joshtyler/delay-line/kicad/README.MD

Lattice_iCE_FPGA.lib is from https://github.com/xesscorp/KiCad-Schematic-Symbol-Libraries

kifield -x output_pcb.sch fpga.sch -i output_pcb_fields.csv
Swap fields to go the other way
