joshtyler/delay-line/kicad/output_pcb/README.MD

Lattice_iCE_FPGA.lib is from https://github.com/xesscorp/KiCad-Schematic-Symbol-Libraries

kifield -x output_pcb.sch fpga.sch -i output_pcb_fields.csv
Swap fields to go the other way

Errata:
v1.0 - BAT54s diode is backwards, remedy is solder upside down.
