joshtyler/delay-line/report/docs/appendices.tex

\clearpage
\begin{appendices}
	
\chapter{Folder Structure} \label{sec:folder-struct}

The project is structured as a single repository using the git version control system. For the reader unfamiliar with git, the project folder may be treated as an ordinary computer folder, however there exists inside the root of the directory a hidden folder, \texttt{.git}, which contains the entire history of the project. This history is not of use to a user only interested in the latest state of the project, but is useful to find files or parts of files which may have been deleted. An example of such files are the project files for the Lattice and Xilinx toolchains, which were later replaced in the project by the open-source Project IceStorm toolchain.

The philosophy of the project repository is that it should not contain any:
\begin{itemize}
	\item Files not directly related to the project itself (e.g. reference material)
	\item Auxillary files automatically generated by tools
	\item Binary files that may be easily regenerated by tools
\end{itemize}
but should contain:
\begin{itemize}
	\item Design files
	\item Project files/configuration files used by tools
	\item Documentation files, even if they may be re-generated (e.g. \LaTeX{} generated \texttt{.pdf} files), provided they are not excessively bulky.
\end{itemize}
This philosophy is enforced inside the repository using \texttt{.gitignore} files.

The structure of each sub-folder in the project repository is shown Figure \ref{fig:repo-dir-struct} (in alphabetical order).

Note that unlabelled folders contain identical types of files to the same name of folder elsewhere in the hierarchy.

\begin{figure}[ht]
	\dirtree{%
		.1 admin \DTcomment{Administration files. E.g. purchase orders}.
		.1 demo \DTcomment{\LaTeX{} files used to generate the project demonstration slides}.
			.2 figs \DTcomment{Figures used in the slides}.
		.1 hdl \DTcomment{\Glsentryshort{hdl} design files/project files, and simulation testbenches}.
			.2 common \DTcomment{Common Verilog constructs used across multiple designs}.
				.3 sim \DTcomment{SystemVerilog Simulation testbenches}.
				.3 sim\_modelsim \DTcomment{ModelSim project file for simulation}.
				.3 src \DTcomment{Synthesizable Verilog code}.
			.2 delay\_line \DTcomment{Files related to the delay line \glsentryshort{hdl} design}.
				.3 icestorm \DTcomment{Makefile for the Project IceStorm toolchain}.
				.3 sim.
				.3 sim\_modelsim.
				.3 src.
			.2 test\_harness \DTcomment{Files related to the test harness \glsentryshort{hdl} design}.
				.3 icestorm.
				.3 sim.
				.3 sim\_modelsim.
				.3 src.
		.1 report \DTcomment{\LaTeX files used to generate the project report (this document)}.
			.2 docs \DTcomment{\LaTeX source files that are not the master project file}.
			.2 figs.
			.2 refs \DTcomment{Files for \textsc{Bib}\TeX{} referencing}.
		.1 sch \DTcomment{Contains KiCAD files used to draw the schematics for the project}.
			.2 delay\_line \DTcomment{Contains the schematic files of the delay line}.
			.2 delay\_line \DTcomment{Contains the schematic files of the test harness}.
		.1 software \DTcomment{Supporting software intended to run on a \glsentryshort{pc}}.
			.2 mem\_gui \DTcomment{Source related to the \glsentryshort{gui} software that talks to the test harness}.
				.3 {.idea} \DTcomment{Project files for CLion}.
				.3 ftdi\_wrapper \DTcomment{Source for wrapping the FTDI driver}.
				.3 generic\_classes \DTcomment{Source for classes used in various parts of the project}.
				.3 main\_gui \DTcomment{Source to implement \glsentryshort{gui} itself}.
				.3 memory\_manager \DTcomment{Source to monitor each unit of \glsentryshort{edsac} memory}.
				.3 status\_manager \DTcomment{Source to control the state of the system}.
				.3 uart\_manager \DTcomment{Source to control the transmission and receipt of messages}.
				.3 uart\_msg \DTcomment{Source relating to \glsentryshort{uart} message formats}.
			.2 uart\_msg\_const\_gen \DTcomment{A script to generate \glsentryshort{uart} message constant header files}.
				.3 cpp\_out \DTcomment{Output folder for C++ header(s)}.
				.3 verilog\_out \DTcomment{Output folder for Verilog header(s)}.
		.1 spice \DTcomment{LTspice simulation schematics}.
			.2 component\_models \DTcomment{Models for various components used in the design}.
	}
	\caption{Repository directory structure}
	\label{fig:repo-dir-struct}
\end{figure}

\chapter{Project Planning Charts} \label{app:proj-plan-charts}

This Gantt Chart shown in Figure \ref{fig:gantt-chart} shows how time on the project was actually spent, and this is in comparison to the \gls{pert} chart of Figure \ref{fig:pert-chart} which shows how time was initially planned to be spent at the start of the project.

These charts are discussed more fully in Chapter \ref{sec:project-planning}.

%Redefine drawing constants to what they were in the lit review.
%Hacky but it works
%Just be sure to not use any of the "normal" tikz setup after this point
\renewcommand{\tikzStateNodeDist}{0.75cm}
\newcommand{\tikzBoxWidth}{3.25cm}

\tikzset{font={\footnotesize}} %set small font
\tikzstyle{every state}=[rectangle, rounded corners, fill=black!40,draw=none,minimum width=\tikzBoxWidth,minimum height=2cm] %Setup state machine style
\tikzstyle{pert}=[->, ,>=stealth', auto,node distance=\tikzStateNodeDist,thick, initial text=Reset]

\tikzstyle{critical} = [fill=red!40]
\tikzstyle{criticalPath} = [draw=red]

\newcommand{\pertNode}[4]
{
	\node[state] (#1) [#2]
	{
		\begin{tabular}{c}
			\textbf{\shortstack{#3}}\\
			\hline
			\shortstack{#4}
		\end{tabular}	
	};	
}

\begin{landscape}
\begin{figure}
	\centering
	\begin{tikzpicture}[pert]
	
	\pertNode{lit}{critical}{Literature\\Review}{2 Weeks}
	
	\pertNode{tb-des}{right=of lit}{Test Harness\\Design}{1 Week}
	\pertNode{delay-des}{critical,above =of tb-des}{Delay Line\\Design}{2 Weeks}
	\pertNode{amp-des}{below =of tb-des}{Amplifier\\Design}{1 Week}
	
	\pertNode{tb-const}{right=of tb-des}{Test Harness\\Implementation\\and Testing}{1 Week}
	\pertNode{delay-const}{critical, right=of delay-des}{Delay Line\\Implementation\\and Testing}{2 Weeks}
	\pertNode{amp-const}{right=of amp-des}{Amplifier\\Implementation\\and Testing}{2 Weeks}
	
	\coordinate (meet) at ([xshift=\tikzStateNodeDist] tb-const.east);
	
	\pertNode{pcb-des}{critical, right= 2*\tikzStateNodeDist of tb-const}{PCB\\Design}{1 Week}
	
	\pertNode{pcb-test}{critical, right=of pcb-des}{PCB\\Construction\\and Testing}{1 Week}
	
	\pertNode{pcb-doc}{critical, right=of pcb-test}{Formal PCB\\Documentation}{1 Week}
	
	\pertNode{des-doc}{below=of pcb-test}{Formal Design\\Documentation}{2 Weeks}
	
	\coordinate (finish) at ([xshift=\tikzStateNodeDist] pcb-doc.east);
	
	\node[above] at (finish) {Finish};

	\path	(lit)			edge							(tb-des)
	(tb-des)		edge							(tb-const)
	(tb-const)		edge							(meet)
	%
	(lit)			edge[bend left, criticalPath]	(delay-des)
	(delay-des)		edge[criticalPath]				(delay-const)
	(delay-const)	edge[bend left, criticalPath]	(meet)
	%
	(lit)			edge[bend right]				(amp-des)
	(amp-des)		edge							(amp-const)
	(amp-const)		edge[bend right]				(meet)
	%
	(meet)			edge[criticalPath]				(pcb-des)
	(pcb-des)		edge[criticalPath]				(pcb-test)
	%
	(meet)			edge[bend right]				(des-doc)
	(des-doc)		edge[bend right]				(finish)
	%
	(pcb-test)		edge[criticalPath]				(pcb-doc)
	(pcb-doc)		edge[criticalPath]				(finish);
	
	\end{tikzpicture}
	\caption{\glsentryshort{pert} chart used to plan the project}
	\label{fig:pert-chart}
\end{figure}
\end{landscape}

\begin{figure}
	\centering
	\resizebox{\textwidth}{!}{
		\input{figs/gantt/gantt}	
	}
	\caption{Gantt chart showing how time was allocated in the project}
	\label{fig:gantt-chart}
\end{figure}

\chapter{Schematics}
This appendix includes the schematics for the delay line and test harness.

%\begin{landscape}
	\includepdf[landscape]{figs/schematics/delay_line}
	\includepdf[landscape]{figs/schematics/test_harness}
%\end{landscape}

\chapter{\glsentryshort{hdl} verification results} \label{app:sim-wfms}
This appendix includes the the simulation waveforms resulting from verification.

The waveforms are included here since they are more clearly presented in landscape format, however they are discussed in Section \ref{sec:hdl-verif}.

\begin{landscape}

\begin{figure}[ht]
	\centering
	
	\begin{subfigure}[b]{\linewidth}
		\centering
		
		\caption{Full simulation}
		\label{fig:delay-sim-full}
	\end{subfigure}
	
	\begin{subfigure}[b]{\linewidth}
		\centering
		
		\caption{Simulated output of a single pulse}
		\label{fig:delay-sim-single}
	\end{subfigure}
	
	\caption{Delay line simulation results}
	\label{fig:delay-sim}
\end{figure}

\begin{figure}[ht]
	\centering
	
	\caption{Full Simulation}
	\label{fig:harness-full}
\end{figure}

\end{landscape}

\end{appendices}
