joshtyler/delay-line/report/docs/acronyms.tex

\newacronym{edsac}{EDSAC}{electronic delay storage automatic calculator}
\newacronym{eniac}{ENIAC}{electronic numerical integrator and computer}
\newacronym{tnmoc}{TNMoC}{The National Museum of Computing}
\newacronym{leo}{LEO}{Lyons electronic office}
\newacronym{fpga}{FPGA}{field programmable gate array}
\newacronym{dc}{DC}{direct current}
\newacronym{ac}{AC}{alternating current}
\newacronym{pcb}{PCB}{printed circuit board}
\newacronym{ram}{RAM}{random access memory}
\newacronym{hdl}{HDL}{hardware description language}
\newacronym{fifo}{FIFO}{first in, first out}
\newacronym{risc}{RISC}{reduced instruction set computing}
\newacronym{arm}{ARM}{advanced RISC machine} %This breaks if using \gls{risc}
\newacronym{uart}{UART}{universal asynchronous receiver/transmitter}
\newacronym{gpio}{GPIO}{general purpose input/output}
\newacronym{ic}{IC}{integrated circuit}
\newacronym{rc}{RC}{resistor-capacitor}
\newacronym{cpld}{CPLD}{complex programmable logic device}
\newacronym{pll}{PLL}{phase locked loop}
\newacronym{lc}{LC}{logic cell}
\newacronym{lut}{LUT}{look-up table}
\newacronym{tqfp}{TQFP}{thin quad flat package}
\newacronym{vhdl}{VHDL}{VHSIC hardware definition language}
\newacronym{spice}{SPICE}{simulation program with integrated circuit emphasis}
\newacronym{lvcmos}{LVCMOS}{low voltage complementary metal oxide semiconductor}
\newacronym{gbp}{GBP}{gain-bandwidth product}
\newacronym{ldo}{LDO}{low-dropout}
\newacronym{rcbo}{RCBO}{residual-current circuit breaker with overcurrent protection}
\newacronym{rms}{RMS}{root mean square}
\newacronym{pc}{PC}{personal computer}
\newacronym{gui}{GUI}{graphical user interface}
\newacronym{pld}{PLD}{programmable logic device}
\newacronym{pert}{PERT}{project evaluation and review technique}
\newacronym{usb}{USB}{universal serial bus}
\newacronym{ftdi}{FTDI}{Future Technology Devices International}
\newacronym{spi}{SPI}{serial peripheral interface}
\newacronym{hf}{HF}{high frequency}
\newacronym{hv}{HV}{high voltage}
