joshtyler/delay-line/report/figs/gantt/gantt.tex

%\documentclass{standalone}
%\usepackage{pgfgantt} %Gantt charts
%\begin{document}
\begin{ganttchart}[hgrid, vgrid, x unit=2mm, title label font = \footnotesize, time slot format =isodate]{2017-06-05}{2017-09-09}
	\gantttitlecalendar{year, month=name, week=1}\\
		
	\ganttgroup[name=delay-hdl]{Initial delay line HDL implementation}{2017-06-06}{2017-06-13} \\
	\ganttbar[name=delay-research]{Architecture Research}{2017-06-06}{2017-06-06} \\
	\ganttlinkedbar{Verilog Implementation}{2017-06-07}{2017-06-13} \\
	\ganttbar[name=delay-tb]{Testbench Design}{2017-06-07}{2017-06-13}\\
	\ganttlink{delay-research}{delay-tb}
	
	\ganttgroup[name=harness-hdl]{Initial test harness HDL implementation}{2017-06-13}{2017-06-21} \\
	\ganttbar[name=harness-sys-des]{Requirements capture and system design}{2017-06-13}{2017-06-13} \\
	\ganttlinkedbar{Verilog Implementation}{2017-06-13}{2017-06-21} \\
	\ganttbar[name=harness-tb]{Testbench Design}{2017-06-13}{2017-06-21} \\
	\ganttlink{harness-sys-des}{harness-tb}
	
	\ganttgroup[name=gui]{Initial Test Harness GUI Design}{2017-06-21}{2017-06-29} \\
	\ganttbar{Creation of proof-of-concept UART driver program}{2017-06-21}{2017-06-22} \\
	\ganttbar{C++ program architecture design}{2017-06-22}{2017-06-22} \\
	\ganttlinkedbar{C++ implementation}{2017-06-23}{2017-06-29} \\

	\ganttgroup[name=initial-integ]{Digital design integration and improvement}{2017-07-03}{2017-07-11} \\
	\ganttlink{delay-hdl}{initial-integ}
	\ganttlink{harness-hdl}{initial-integ}
	\ganttlink{gui}{initial-integ}
	
	\ganttbar{Integration testing of test harness GUI, test harness, and delay line}{2017-07-03}{2017-07-07} \\
	\ganttlinkedbar{GUI improvements}{2017-07-07}{2017-07-11} \\
	
	\ganttgroup[name=init-ana]{Initial Analogue Design}{2017-07-12}{2017-07-17} \\
	\ganttbar[name=pwr-investig]{FPGA power investigation}{2017-07-12}{2017-07-12} \\
	\ganttbar{Test harness input/output amplifier design}{2017-07-13}{2017-07-17} \\
	\ganttbar[name=phantom-power-design]{Phantom power circuitry design}{2017-07-17}{2017-07-17} \\
	\ganttlink{pwr-investig}{phantom-power-design}
	
	\ganttgroup[name=phantom-pwr]{Phantom power investigation}{2017-07-19}{2017-08-02} \\
	\ganttlink{init-ana}{phantom-pwr}
	\ganttbar{Research into how valve design works}{2017-07-19}{2017-07-20} \\
	\ganttlinkedbar{SPICE simulation of EDSAC output stage, and phantom power draw}{2017-07-24}{2017-07-27} \\
	\ganttlinkedbar{Redesign of phantom power circuitry}{2017-07-28}{2017-07-31} \\
	\ganttlinkedbar{Investigation into regeneration input circuitry}{2017-08-01}{2017-08-02} \\
	
	\ganttgroup[name=final-build]{Building final delay line circuitry}{2017-08-03}{2017-09-01} \\
	\ganttlink{init-ana}{final-build}
	\ganttlink{phantom-pwr}{final-build}
	\ganttbar{Selection of parts to order, and ordering}{2017-08-03}{2017-08-04} \\
	\ganttlinkedmilestone{Parts ordered}{2017-08-04} \\
	\ganttlinkedmilestone{Parts arrive}{2017-08-09} \\
	\ganttlinkedbar{Assembling and testing sub-systems}{2017-08-10}{2017-08-15} \\
	\ganttlinkedbar[name=integ-for-demo]{Integration testing and modification}{2017-08-16}{2017-08-22} \\
	\ganttlinkedbar{Re-implement part of circuit to improve noise crosstalk}{2017-08-25}{2017-08-28} \\
	\ganttlinkedbar[name=tmnoc-prep]{Preparation of project to visit TNMoC}{2017-09-01}{2017-09-01} \\

	\ganttmilestone{Visit to TNMoC}{2017-06-27}
	\ganttmilestone[name=tmnoc-second-visit]{Visit to TNMoC}{2017-09-04} \\
	\ganttlink{tmnoc-prep}{tmnoc-second-visit}
	
	\ganttmilestone[name=demo]{Project demonstration}{2017-08-30} \\
	\ganttlink{integ-for-demo}{demo}
	
	\ganttmilestone[name=handin]{Report handin}{2017-09-07} \\
	
	\ganttgroup{Documentation}{2017-08-07}{2017-09-06} \\
	\ganttbar{Report writing}{2017-08-07}{2017-08-09}
	\ganttbar{}{2017-08-23}{2017-08-24}
	\ganttbar{}{2017-08-30}{2017-08-31}
	\ganttbar{}{2017-09-02}{2017-09-03}
	\ganttbar{}{2017-09-05}{2017-09-05} \\
	\ganttbar{Design of diagrams}{2017-08-29}{2017-08-29} \\
	\ganttbar[name=checking]{Report checking}{2017-09-06}{2017-09-06} \\
	\ganttlink{checking}{handin}	
	
\end{ganttchart}
%\end{document}
