joshtyler/delay-line/report/figs/driver-heatsink.jpg

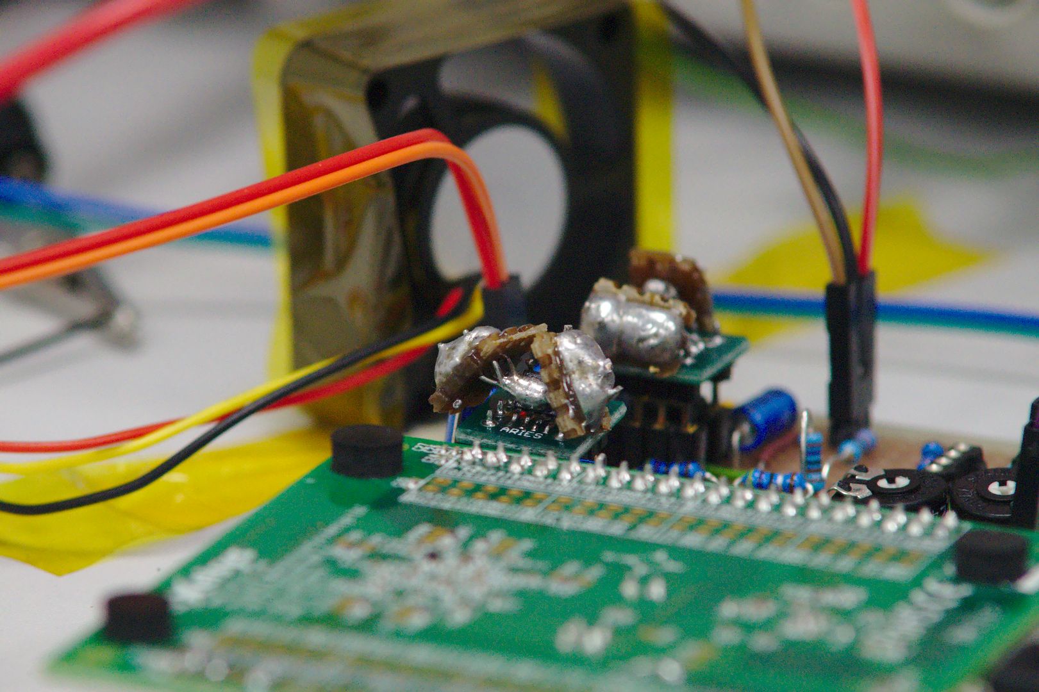
report/figs/driver-heatsink.jpg
