joshtyler/delay-line/report/figs/integration/fpga_reset.jpg

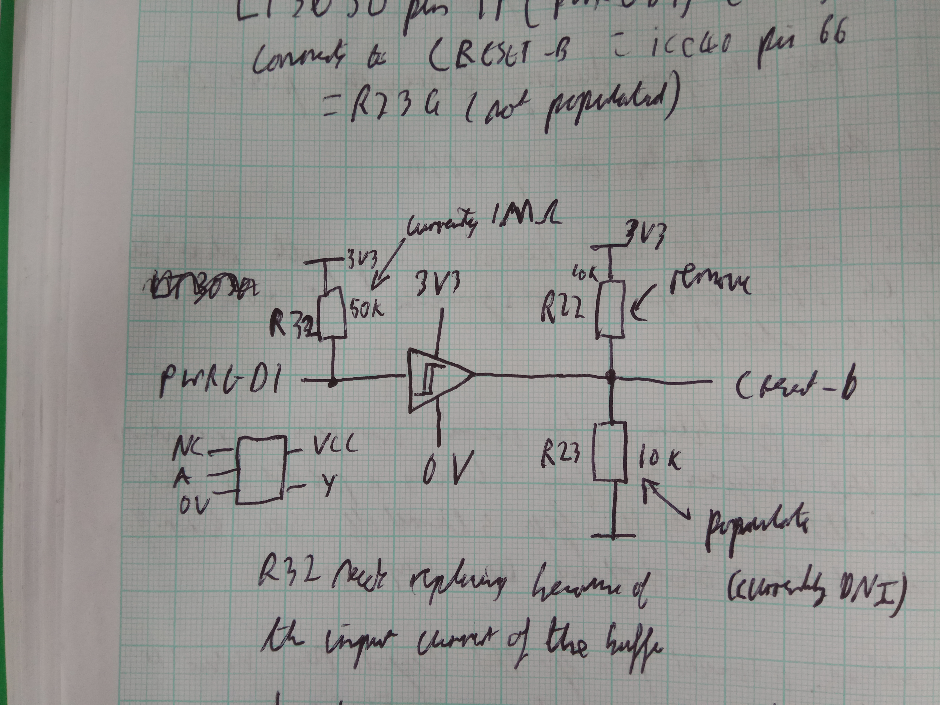
report/figs/integration/fpga_reset.jpg
