joshtyler/delay-line/report/figs/integration/passive_attenuator.jpg

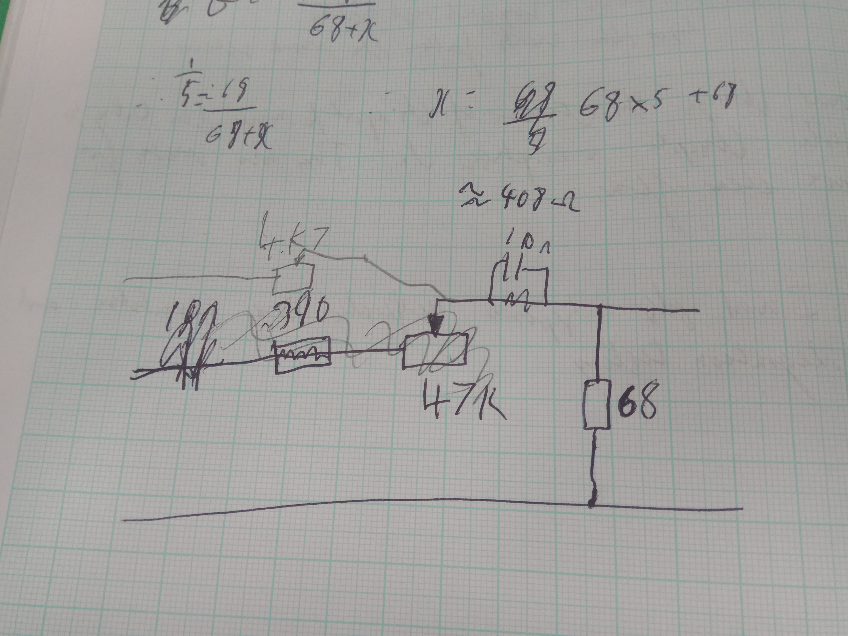
report/figs/integration/passive_attenuator.jpg
