joshtyler/delay-line/report/figs/schematic_portions/delay_line_input.png

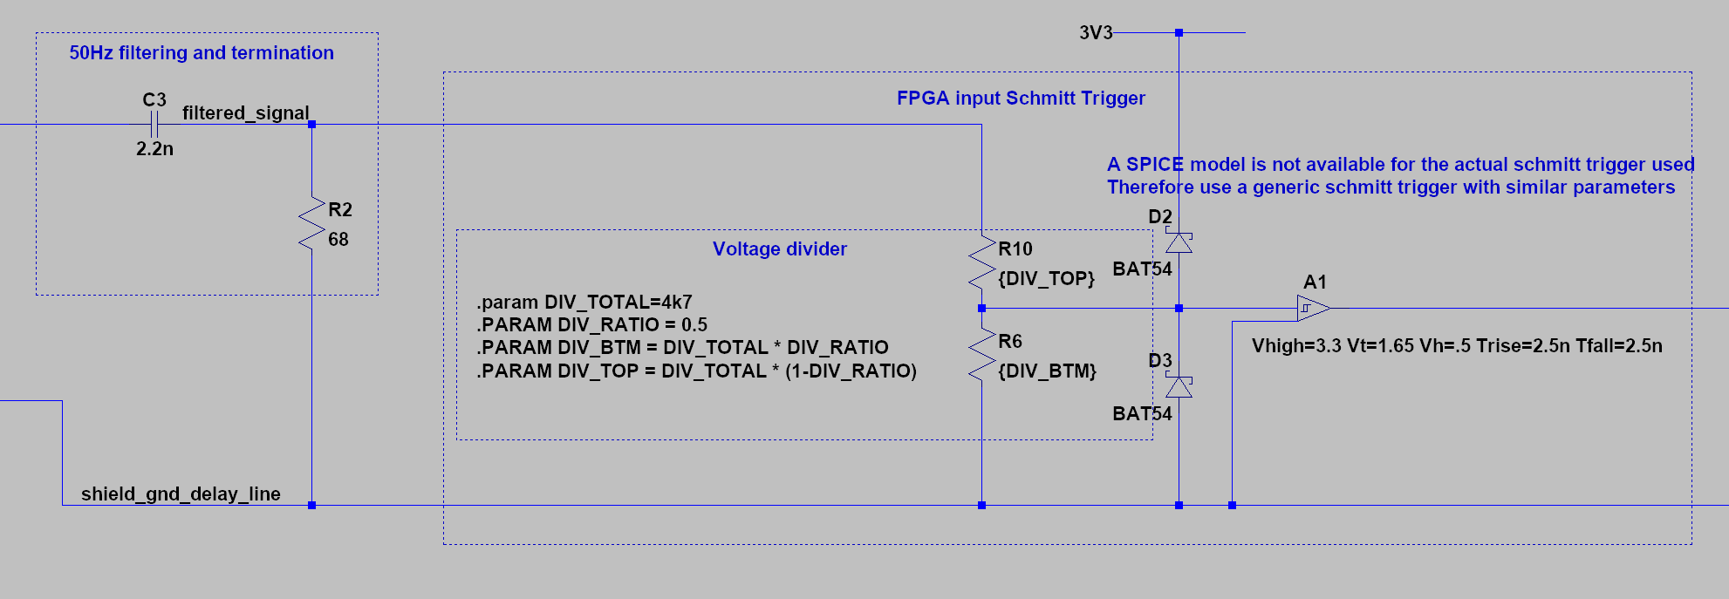
report/figs/schematic_portions/delay_line_input.png
