joshtyler/delay-line/report/figs/schematic_portions/delay_line_output.jpg

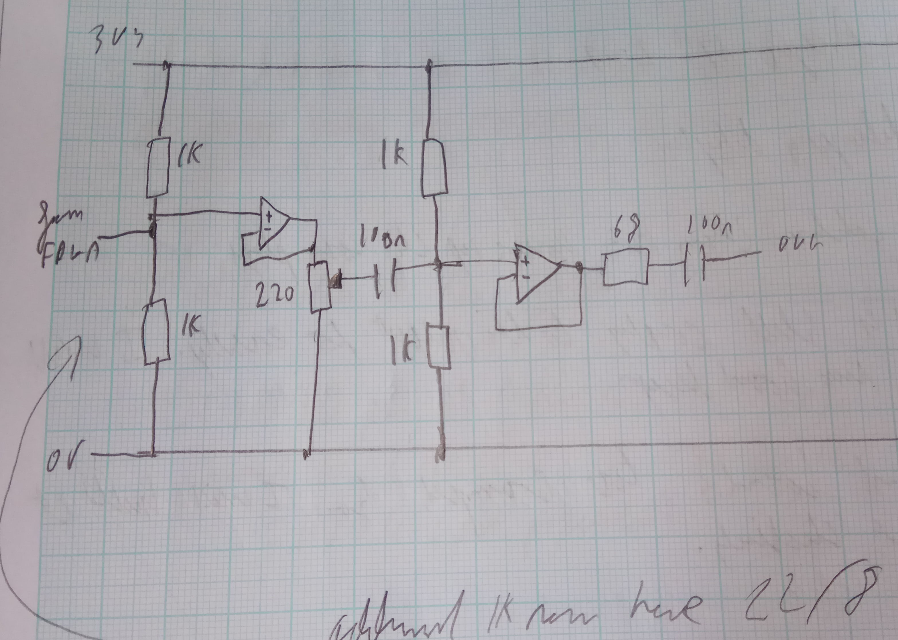
report/figs/schematic_portions/delay_line_output.jpg
