joshtyler/delay-line/report/figs/schematic_portions/delay_line_psu.jpg

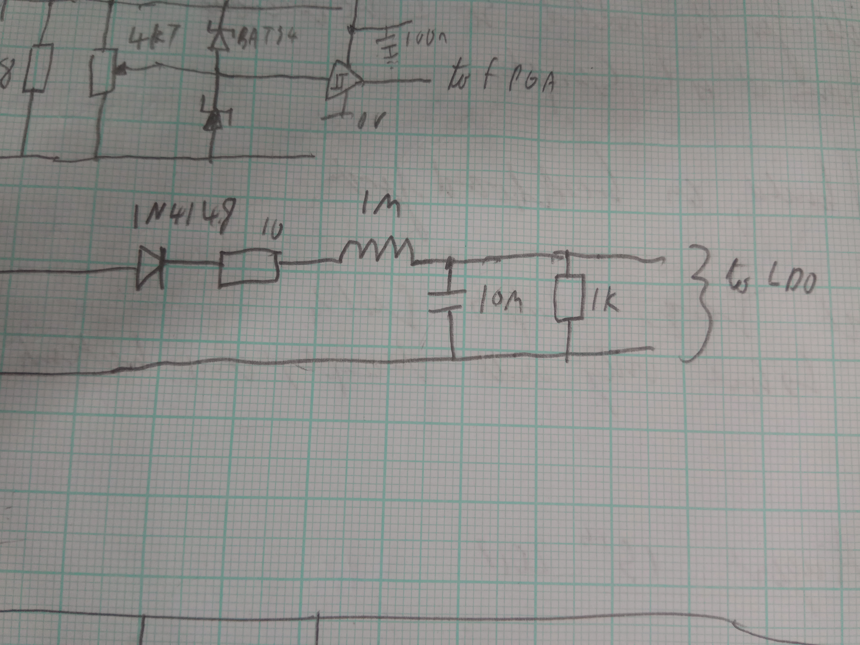
report/figs/schematic_portions/delay_line_psu.jpg
