joshtyler/delay-line/admin/Farnell order 20170804.ods

Part | MOQ | Qty to order | Supplier | Order Code | Price Each | Price Total
BAT54S Shottkey diodes | 1 | 25 | Farnell | 1612328 | £0.07 | £1.73
68Ohm 3W resistor | 1 | 5 | Farnell | 1738673 | £0.18 | £0.89
74LVC1G17W5-7 Schmitt trigger | 1 | 10 | Farnell | 1893835 | £0.26 | £2.60
1mH Inductor | 1 | 5 | Farnell | 2457854 | £0.48 | £2.41
10mF Cap | 1 | 3 | Farnell | 2346513 | £1.88 | £5.64
LMH6639 op-amp | 1 | 5 | Farnell | 1312810 | £1.25 | £6.25
LM7372 op-amp | 1 | 3 | Farnell | 1286929 | £5.44 | £16.32
SOT-23 adapter | 1 | 7 | Farnell | 2474683 | £1.62 | £11.34
SOIC adapter | 1 | 3 | Farnell | 2476033 | £2.05 | £6.15
Matrixboard | 1 | 1 | Farnell | 2762514 | £2.58 | £2.58
Matrixboard | 1 | 1 | Farnell | 2474675 | £3.43 | £3.43
Total |  |  |  |  |  | £59.34
