joshtyler/delay-line/spice/component_models/README.MD

This folder contains the simulation models for various components
