joshtyler/delay-line/admin/Farnell order 20180206.ods

Part | Min qty needed | Qty to order | Supplier | Order Code | Price Each | Price Total | Comment | Quick order
68R 0603 R | 2 | 50 | RS | 213-2115 | £0.00 | £0.15 |  | 213-2115,50
100k 0603 R | 1 | 5 | RS | 566-787 | £0.09 | £0.46 |  | 566-787,5
100u 1210 C | 1 | 5 | RS | 846-7363 | £0.78 | £3.89 |  | 846-7363,5
10u 0805 C | 2 | 10 | RS | 698-3544 | £0.08 | £0.81 |  | 698-3544,10
1k 0603 R | 2 | 50 | RS | 213-2266 | £0.01 | £0.40 |  | 213-2266,50
220k 0603 R | 1 | 50 | RS | 213-2581 | £0.01 | £0.70 |  | 213-2581,50
22u 0603 C | 1 | 10 | RS | 758-8083 | £0.13 | £1.33 |  | 758-8083,10
SMA Right angle | 5 | 5 | RS | 783-9647 | £1.23 | £6.15 |  | 783-9647 ,5
iCE40-HX1K-TQ144 | 1 | 2 | RS | 772-0041 | £4.62 | £9.24 | Could order 1 | 772-0041,2
LFSPXO025492 | 1 | 2 | RS | 671-5701 | £2.81 | £5.62 |  | 671-5701 ,2
MBR0520L Diode | 2 | 10 | RS | 739-0521 | £0.27 | £2.66 |  | 739-0521,10
SST25VF512A EEPROM | 1 | 5 | RS | 723-8757 | £0.36 | £1.80 |  | 723-8757,5
2n2 0603 C | 1 | 25 | RS | 264-4573 | £0.02 | £0.50 |  | 264-4573,25
Total |  |  |  |  |  | £33.71
Order from ebay
LM1117-3.3 | x
0603 Red LEDs | x
NCV8114ASN120T1G | X
