joshtyler/delay-line/report/figs/integration/testing.jpg

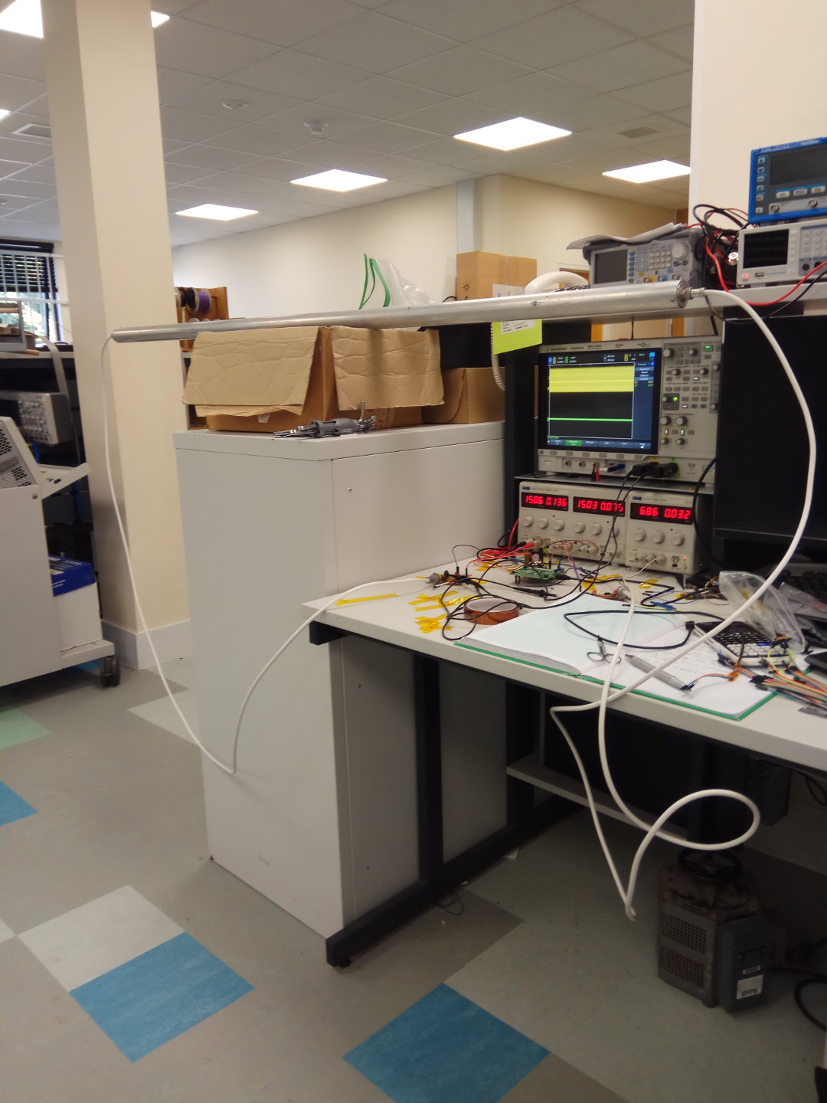
report/figs/integration/testing.jpg
