joshtyler/delay-line/report/figs/schematic_portions/test_harness_input.jpg

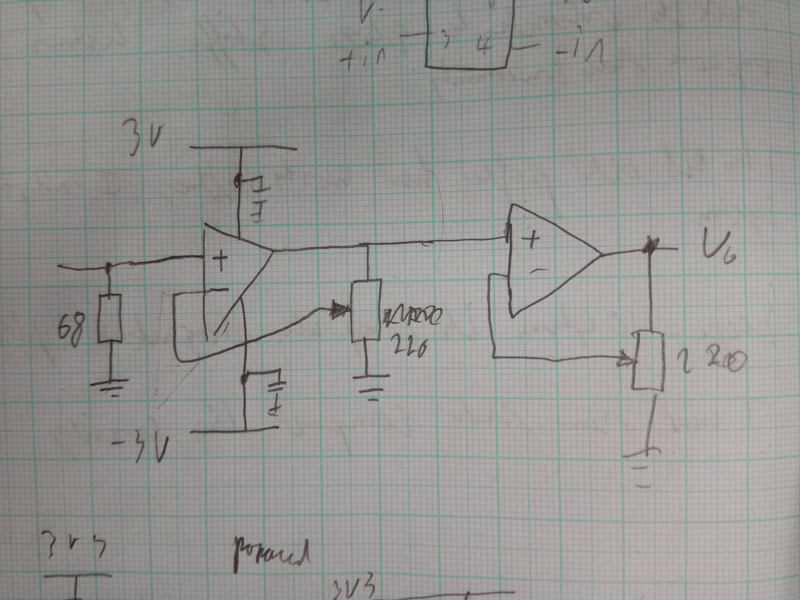
report/figs/schematic_portions/test_harness_input.jpg
