joshtyler/delay-line/report/figs/schematic_portions/test_harness_output.jpg

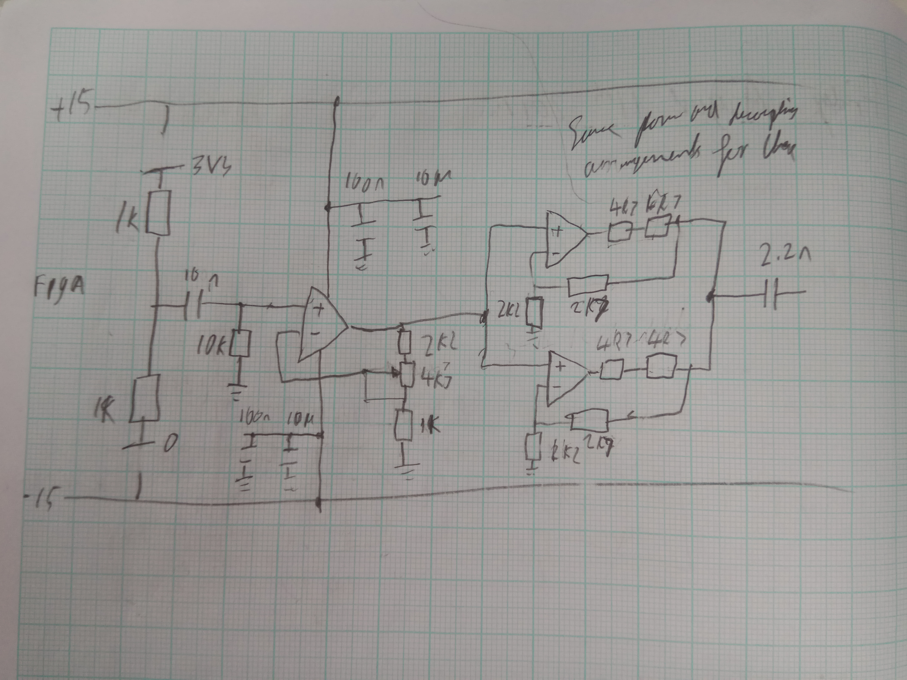
report/figs/schematic_portions/test_harness_output.jpg
