joshtyler/delay-line/report/figs/gantt/gantt.pdf

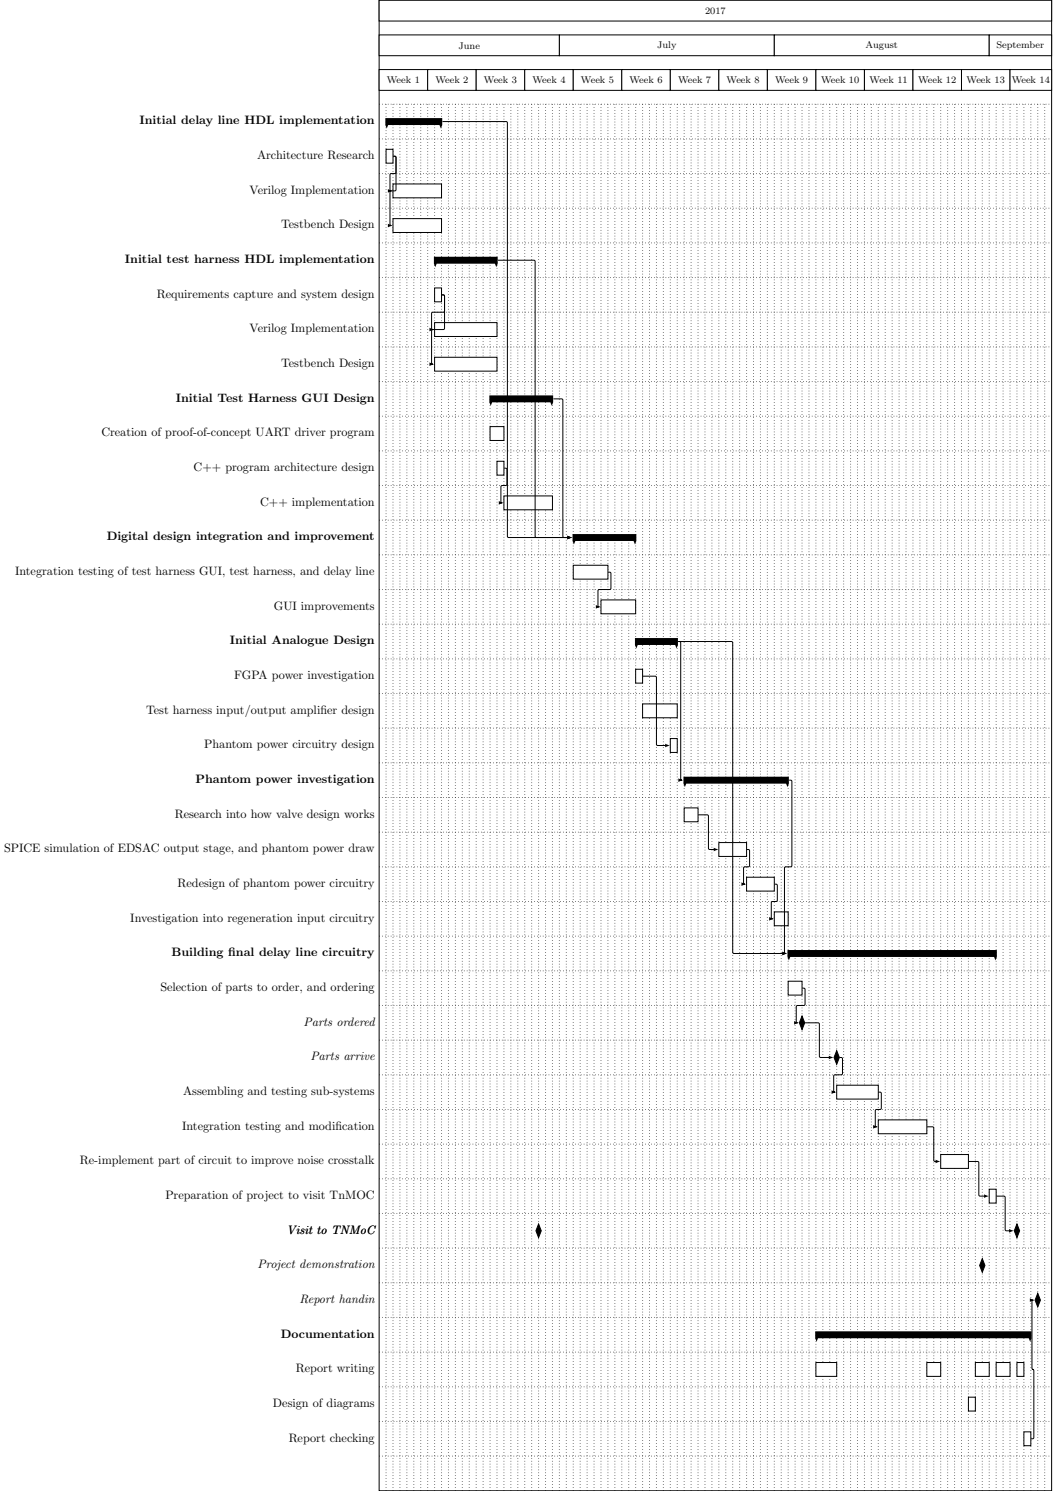
[picture p53: page 1]
June; July; August; September; Week 1; Week 2; Week 3; Week 4; Week 5; Week 6; Week 7; Week 8; Week 9; Week 10 Week 11 Week 12 Week 13 Week 14; Architecture Research; Verilog Implementation; Testbench Design; C++ implementation; GUI improvements; Parts ordered; Parts arrive; Project demonstration; Report handin; Documentation; Report writing; Report checking

Initial delay line HDL implementation

Initial test harness HDL implementation

Requirements capture and system design

Initial Test Harness GUI Design

Creation of proof-of-concept UART driver program

C++ program architecture design

Digital design integration and improvement

Integration testing of test harness GUI, test harness, and delay line

Initial Analogue Design

FGPA power investigation

Test harness input/output amplifier design

Phantom power circuitry design

Phantom power investigation

Research into how valve design works

SPICE simulation of EDSAC output stage, and phantom power draw

Redesign of phantom power circuitry

Investigation into regeneration input circuitry

Building final delay line circuitry

Selection of parts to order, and ordering

Assembling and testing sub-systems

Integration testing and modification

Re-implement part of circuit to improve noise crosstalk

Preparation of project to visit TnMOC

Visit to TNMoC

Design of diagrams
