joshtyler/delay-line/report/figs/equivalent_circuit/equivalent_circuit.pdf

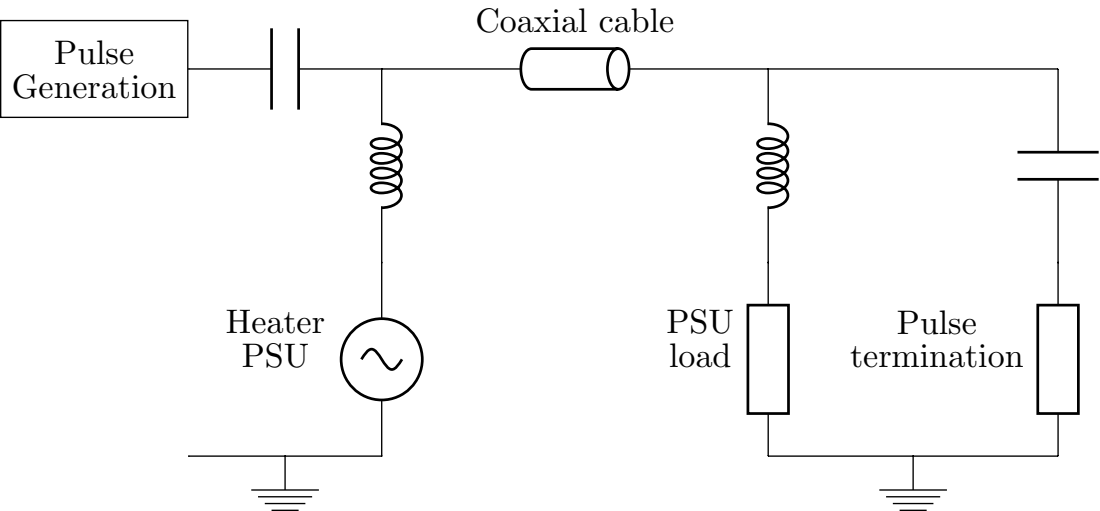
[picture p54: page 1]
Pulse Generation; Heater PSU; Coaxial cable; PSU load; Pulse termination
