joshtyler/delay-line/sch/test_harness.pdf

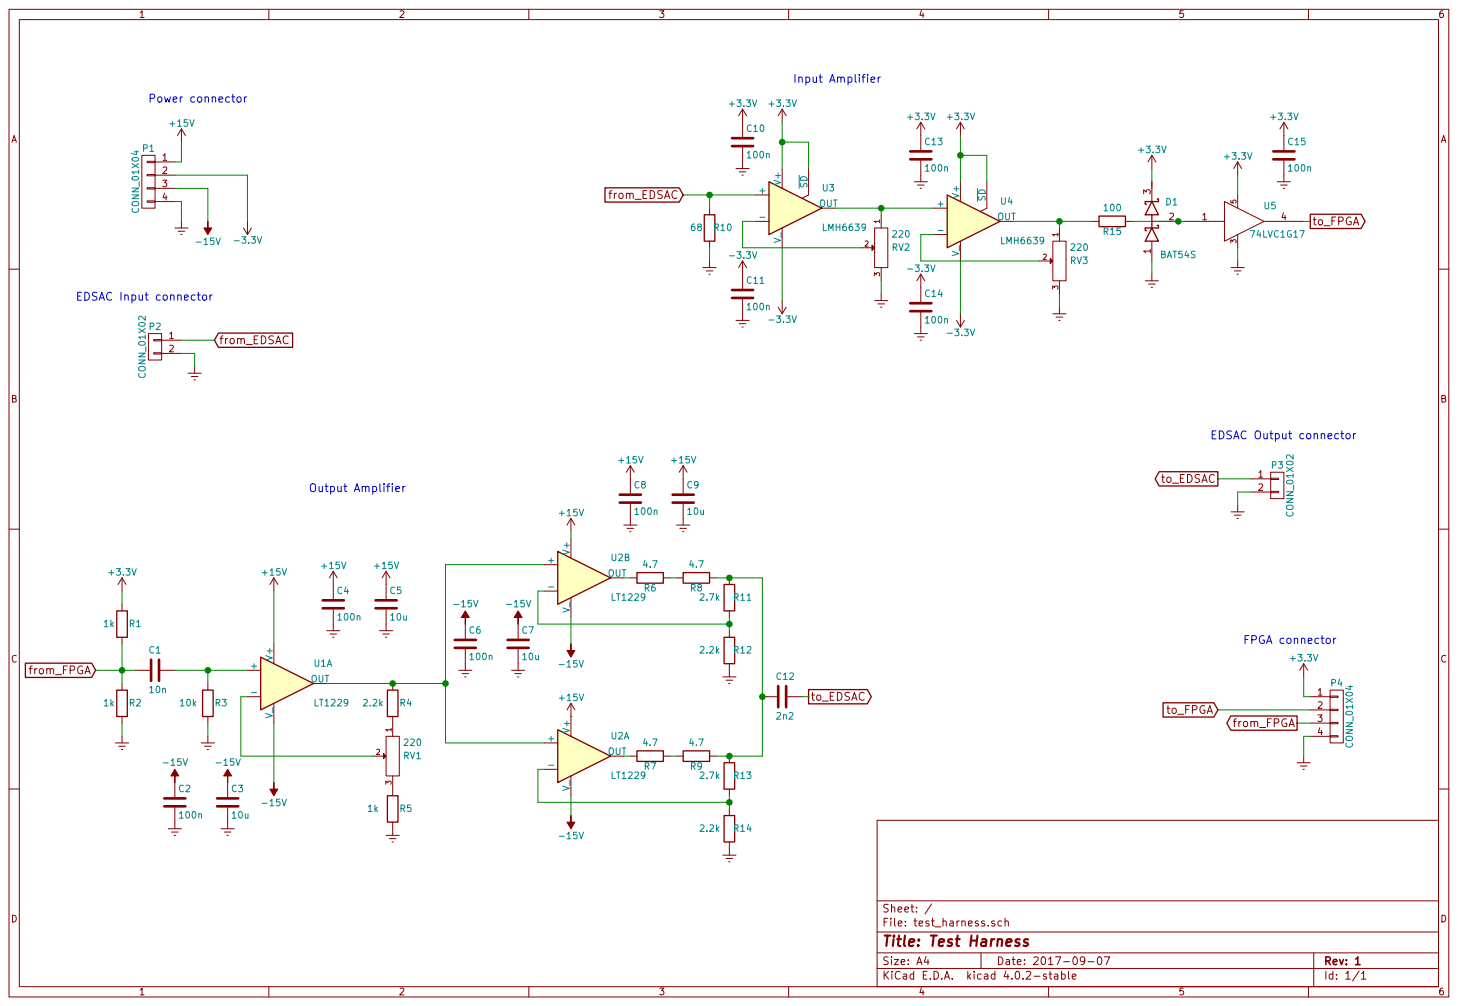
[picture p55: page 1]

File: test_harness.sch Sheet: /
Id: 1/1 Title: Test Harness
