joshtyler/delay-line/spice/test_harness_input.asc

A1: schmtbuf; Vhigh=3.3 Vt=1.65 Vh=.5 Trise=2.5n Tfall=2.5n
B1: bv; V=V(mod)*V(carrier)
C3: cap; 4.7µ
D1: schottky; BAT54
D2: schottky; BAT54
R1: res; 1k
R2: res; 2.2k
R3: res; 220
R5: res; 2.2k
R6: res; 22
R8: res; 68
U1: LT1229
U2: LT1229
V1: voltage; 15
V2: voltage; 15
V3: voltage; 3.3
V4: voltage; PULSE(-50m 50m 0 1n 1n 37n 74n)
V5: voltage; PULSE(0 1 0 0 0 0.9u 1.9u)
Named nets: 0, mod, carrier, in, amp1_out, fpga_in, amp2_out, 3V3
.tran 0 110u 100u
