joshtyler/delay-line/spice/test_harness_output.asc

B1: bv; V=1.65+V(carrier)*V(pulse)
C1: cap; 10n
C2: cap; 2.2n
C3: cap; 100n
C4: cap; 10n
Q1: npn; BC547B
Q2: npn; BC547B
Q3: pnp; BC557C
R1: res; 1
R2: res; 1
R3: res; {OP_R}
R4: res; 27k
R5: res; 2k9
R6: res; 1k8
R7: res; 150
R8: res; 820
R9: res; 820
R10: res; 3k3
R11: res; 3k3
R12: res; {OP_R}
R13: res; 4k7
R14: res; 68
R15: res; 1k
R17: res; 10k
R18: res; 1k
R19: res; 1k
U1: LM7372
U2: LM7372
U3: LM7372
V1: voltage; 18
V2: voltage; 18
V4: voltage; PULSE(-1.65 1.65 0 1n 1n 27n 74n)
V5: voltage; PULSE(0 1 0 1n 1n 1u 2u)
Named nets: 0, carrier, pulse, v_in
.tran 0 1.5u 0
4k7 pot
.inc component_models/LM7372.MOD
.param OP_R=68*2
See http://www.intersil.com/content/dam/Intersil/documents/an11/an1111.pdf
.param OP_R=10
