joshtyler/delay-line/spice/clock_buffer_test.asc

C1: cap; 0.5µ
R1: res; 3k3
R2: res; 2k2
R3: res; 1
R4: res; 27
R5: res; 100
R6: res; 100
R7: res; 100k
U1: EF54
V1: voltage; 250
V2: voltage; PULSE(0 20 0 0.1u 0.1u 1u 2u)
Named nets: 0, h
.INCLUDE valve-lib\\EF54.sub
.tran 0 110u 100u
Spice commands
0V is tied to earth at some point in the distance
.INCLUDE valve-lib\\EF55.sub
.INCLUDE valve-lib\\Socket_B9G.sub
