joshtyler/delay-line/spice/store_regen_input.asc

B1: bv; V=V(carrier)*V(pulse)
C1: cap; 10n
C2: cap; 4.7p
C3: cap; 2n
C4: cap; 2n
C5: cap; 10n
C6: cap; 2n
C7: cap; 2n
C8: cap; 2n
C9: cap; 2n
C10: cap; 2n
C11: cap; 50p
C12: cap; 0.5µ
C13: cap; 50p
C20: cap; 10p
L1: ind; 6.25µ
L2: ind; 5.5µ
L3: ind; 3.65µ
L4: ind; 1m
R1: res; 68
R2: res; 10k
R3: res; 3k3
R4: res; 3k3
R5: res; 4k7
R6: res; 150
R7: res; 27
R8: res; 3k3
R9: res; 3k3
R10: res; 4k7
R11: res; 150
R12: res; 27
R13: res; 250k
R14: res; 47k
R15: res; 3k3
R16: res; 100
R17: res; 1k
R18: res; 10k
R19: res; 3k3
R20: res; 1k
R21: res; 27
R22: res; 47k
R23: res; 0.01
R24: res; 68
U1: EF54
U2: EF54
U3: EF54
U4: EA50_box
V1: voltage; 250
V2: voltage; SINE(0 8.9 50); Rser=0.5
V3: voltage; PULSE(-100m 100m 0 1n 1n 27n 74n)
V4: voltage; PULSE(0 1 0 1n 1n 1u 2u)
V5: voltage; PULSE(-15 15 0 1n 1n 27n 74n)
Named nets: input, 0, 0v_isolated, heater_v, TP5, TP4, TP3, TP2, TP1, carrier, pulse
.INCLUDE valve-lib\\EF54-datasheet-added-cap.sub
.tran 0 54u 50u
Spice commands
.inc valve-lib\\EA50.sub
.INCLUDE valve-lib\\Socket_B9G.sub
This is a 250k variable resistor
See "tests on chassis 01" hardware note for info on how to adjust
