joshtyler/delay-line/spice/delay_line_output.asc

B1: bv; V=1.65+V(carrier)*V(pulse)
C1: cap; 100n
C2: cap; 100n
C4: cap; 100n
R1: res; 68
R2: res; 1k
R3: res; 100
R4: res; 10k
R5: res; 10k
R6: res; 68
U1: LMH6639
V1: voltage; 3.3
V2: voltage; PULSE(-1.65 1.65 0 1n 1n 27n 74n)
V3: voltage; PULSE(0 1 0 1n 1n 1u 2u)
Named nets: 0, carrier, pulse, Vcc, v_amp_1_out, vout
.inc component_models/LMH6639.MOD
.tran 0 10u 0
