joshtyler/delay-line/spice/store_regen_output.asc

B1: bv; V=V(duty)*V(pulse)
C1: cap; 0.5µ
C2: cap; 10p
C3: cap; 2n
C4: cap; 10n
C5: cap; 10n
C6: cap; 2n
C7: cap; 10n
C8: cap; 10n
L1: ind; 23µ
L2: ind; 8.5µ
L3: ind2; 1µ
L4: ind2; 1µ
R1: res; 10k
R2: res; 2k2
R4: res; 1k
R5: res; 220
R6: res; 68
R7: res; 4k7
R8: res; 270k
R9: res; 1T
U1: EF54
U2: EF55
V1: voltage; 250
V2: voltage; PULSE(0 -20 0 0.1u 0.1u 1u 2u)
V3: voltage; PULSE(0 1 0n 0.1n 0.1n 4u 8u)
V4: voltage; 6.3
Named nets: 0, Enable, h, duty, pulse, out, 0V_isolated, ground
.INCLUDE valve-lib\\EF54-empirical.sub
.tran 0 70u 50u
Spice commands
Value of this cap isn't explicitly stated
.INCLUDE valve-lib\\EF55.sub
.INCLUDE valve-lib\\Socket_B9G.sub
Value of L1 is derived from estimations using photographs.
It's value is estimated to be 7-39uH
Note: The simulation only works with a load on the output!
Change this resistor to 68R to sim indepentantly
Centre tapped inductor
Hence mutual inductance
Interestingly sim works without this.
K1 L3 L4 0.7
Mutual inductance value is an estimate
Ground, and 0V isolated need to connect to ground for independant simulation
