joshtyler/delay-line/spice/top_transformer.asc

A1: schmtbuf; Vhigh=3.3 Vt=1.65 Vh=.5 Trise=2.5n Tfall=2.5n
C1: cap; 10m
C2: cap; 0.01µ
C3: cap; 2.2n
C4: cap; 10µ
C5: cap; 0.01µ
C6: cap; 4.7µ
D1: diode; 1N4148
D2: schottky; BAT54
D3: schottky; BAT54
L1: ind; 1m
L2: ind; 1m
R1: res; {GND_R}
R2: res; 68
R3: res; 220
R4: res; 1Meg
R5: res; 10
R6: res; {DIV_BTM}
R7: res; 0.5
R8: res; 0.5
R9: res; {GND_R}
R10: res; {DIV_TOP}
R12: res; 1Meg
R13: res; 357k
R14: res; 210k
R15: res; 100k
R16: res; 0.1
R17: res; 80
R18: res; 1k
R19: res; {GND_R}
R20: res; 0.1
R21: res; {GND_R}
U1: LT3030
X1: dummy_edsac
X2: heater_psu
Named nets: shield_gnd_edsac, 0, shield_gnd_delay_line, from_edsac, filtered_signal, data_to_fpga, 3V3, 1V2, smoothing_cap, edsac_0v_isolated, heater_ground
.tran 0 0.1 0
Coax
.param GND_R=0.5
.model PL1 LTRA(len=1 R=92m L=376n C=67p)
This is the top level schematic of store regeneration -> delay line frontend.
The delay line front end can either be modeled as using the actual valve level model, or a dummy model which emulates the signal (faster).
This is a model for the URM70 Coax which EDSAC uses.
For normal usage the coax is not simulated because it is incredibly slow.
Supply rectification and filtering.
 
Half wave rectification is sufficient due to low power draw,
and avoids need for transformer.
50Hz filtering and termination
FPGA Dev board power supply
(Prexisting on FPGA dev board).
N.B. LT3030 is a dual output LDO
Voltage divider
.param DIV_TOTAL=4k7
.PARAM DIV_RATIO = 0.5
.PARAM DIV_BTM = DIV_TOTAL * DIV_RATIO
.PARAM DIV_TOP = DIV_TOTAL * (1-DIV_RATIO)
FPGA input Schmitt Trigger
Nominal current is 15mA
Nominal current is 15mA
N.B. 100R RESISTORS HAVE BEEN REMOVED FROM EACH CHANNEL OF PSU OUTPUT.
FPGA dev board should be modified to reflect this.
(They contribute a very significant amount to the current draw, and are not necessary for stability)
.ic V(smoothing_cap)=5.76 V(3v3)=3.3 V(1V2)=1.2
Set initial value of smoothing_cap to speed up simulation of fpga input.
Comment out directive and delete EDSAC store for detailed simulation of phantom power supply
(or use dummy edsac store and tolerate slow simulation speed)
A SPICE model is not available for the actual schmitt trigger used
Therefore use a generic schmitt trigger with similar parameters
Resistors to mimic load
1mH inductor presents high impedance to 13.5MHz signal,
but low impedance to mains
These components exist inside EDSAC
In reality the ground points are connected in the distance and may float at slightly different potentials.
These resistors provide a naive way of modelling this.
These components exist inside the delay line
Model of FPGA input
.tran 0 2 0
.ic V(smoothing_cap)=0 V(3v3)=0 V(1V2)=0
