joshtyler/delay-line/spice/dummy_edsac.asc

B1: bv; V=V(carrier)*V(pulse)
C1: cap; 2n
R1: res; 68
V1: voltage; PULSE(0 25 0 1n 1n 27n 74n)
V2: voltage; PULSE(0 1 0 1n 1n 1u 2u)
Named nets: 0, carrier, pulse, out, 0v_isolated
