joshtyler/delay-line/spice/heater_psu.asc

V1: voltage; SINE(0 {AMPLITUDE } 50 0 0 90); Rser=0.5
Named nets: out, ground
This is a model of the heater power supply.
6.3V at 50Hz.
Series resistance is an estimate
.tran 0 0.1 0
.PARAM AMPLITUDE = sqrt(2)*6.3
