joshtyler/delay-line/kicad/input_pcb/input_pcb.kicad_pcb

## KiCad design kicad/input_pcb/input_pcb.kicad_pcb (2018-05-28)

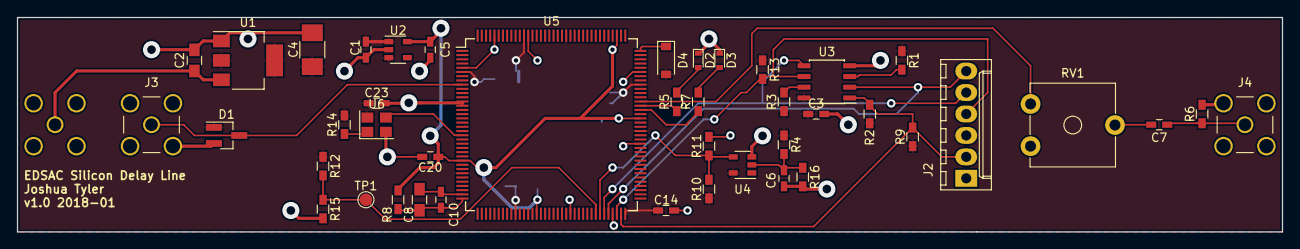
[picture p57: board input_pcb.kicad_pcb from above]

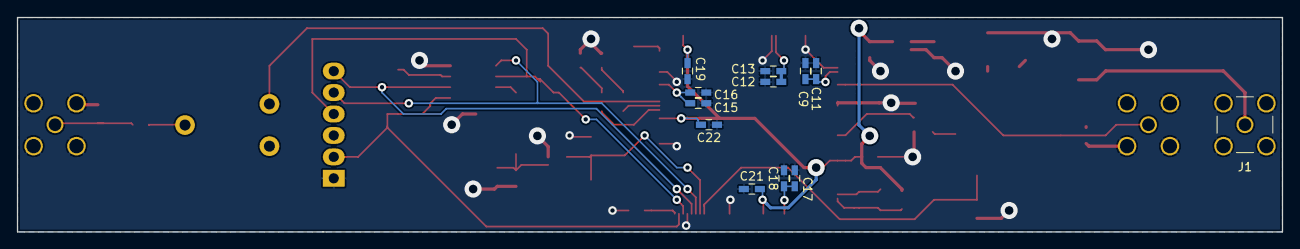
[picture p58: board input_pcb.kicad_pcb from below]

Board: 2 copper layers, 149.9 x 25.4 mm, 55 parts (12 on the bottom side), 26 nets.

Parts:
C1, C5: 1u; C_0603_HandSoldering
C2, C8: 10u; C_0805_HandSoldering
C3, C9, C10, C11, C12, C13, C14, C15, C16, C17, C18, C19, C20, C21, C22, C23: 0.1u; C_0603_HandSoldering
C4: 100u; C_1210_HandSoldering
C6: 22u; C_0603_HandSoldering
C7: 10n; C_0603_HandSoldering
D1: BAT54S; SOT-23_Handsoldering
D2, D3: LED; D_0603
D4: MBR0520L; D_SOD-123
J1, J3, J4: Conn_01x02; SMA_THT_Jack_Straight
J2: Conn_01x06; Molex_KK-6410-06_06x2.54mm_Straight
R1, R2, R3, R9, R10, R12, R13, R14: 10k; R_0603_HandSoldering
R4: 100k; R_0603_HandSoldering
R5, R7: 1k; R_0603_HandSoldering
R6: 68; R_0603_HandSoldering
R8: 100; R_0603_HandSoldering
R11, R15: 10k_DNI; R_0603_HandSoldering
R16: 220k; R_0603_HandSoldering
RV1: 4k7; Potentiometer_Trimmer_ACP_CA9v_Horizontal_Px10.0mm_Py5.0mm
TP1: TEST; Test_Point_Pad_d1.5mm
U1: LM1117-3.3; SOT-223-3_TabPin2
U2: NCV8114ASN120T1G; SOT-23-5
U3: SST25VF512A; SOIC-8_3.9x4.9mm_Pitch1.27mm
U4: 74LVC1G17W5; SOT-23-5
U5: iCE40-HX1K-TQ144; TQFP-144_20x20mm_Pitch0.5mm
U6: LFSPXO025492; Crystal_SMD_3225-4pin_3.2x2.5mm

Connections:
+1V2: C5.1, C19.1, C20.1, C21.1, C22.1, R8.2, U2.5, U5.27, U5.51, U5.92, U5.111
+3V3: C1.1, C3.1, C4.1, C9.1, C11.1, C12.1, C13.1, C14.1, C15.1, C16.1, C17.1, C18.1, C23.1, D1.1, D4.2, J2.3, R1.1, R2.1, R3.1, R4.1, R9.1, R10.1, R12.1, R13.1, R14.2, U1.2, U2.1, U2.3, U3.8, U4.5, U5.6, U5.30, U5.46, U5.57, U5.72, U5.89, U5.100, U5.123, U5.133, U6.4
/FPGA/CDONE: R12.2, R15.1, TP1.1, U5.65
/FPGA/CLK: U5.21, U6.3
/FPGA/debug_1: R7.1, U5.94
/FPGA/debug_2: R5.1, U5.95
/FPGA/to_edsac: RV1.3, U5.96
/PWR_GD: R10.2, R11.1, U4.4, U5.66
/SIG_IN: D1.3, J3.1, U5.9
/SPI_MISO: J2.6, U3.2, U5.68
/SPI_MOSI: J2.5, U3.5, U5.67
/SPI_SCK: J2.4, R13.2, U3.6, U5.70
/SPI_~CS: J2.2, R2.2, R9.2, U3.1, U5.71
/V_IN: C2.1, J1.1, U1.3
GND: C1.2, C2.2, C3.2, C4.2, C5.2, C6.2, C9.2, C11.2, C12.2, C13.2, C14.2, C15.2, C16.2, C17.2, C18.2, C19.2, C20.2, C21.2, C22.2, C23.2, D1.2, D2.1, D3.1, J1.2, J2.1, J3.2, J4.2, R6.2, R11.2, R15.2, R16.2, U1.1, U2.2, U3.4, U4.3, U5.5, U5.13, U5.14, U5.59, U5.69, U5.86, U5.103, U5.132, U5.140, U6.2
unnamed: C6.1, R4.2, R16.1, U4.2
unnamed: C7.1, J4.1, R6.1
unnamed: C7.2, RV1.2
unnamed: C8.1, C10.1, R8.1, U5.36
unnamed: C8.2, C10.2, U5.35
unnamed: D2.2, R5.2
unnamed: D3.2, R7.2
unnamed: D4.1, U5.108
unnamed: R1.2, U3.3
unnamed: R3.2, U3.7
unnamed: R14.1, U6.1
