joshtyler/delay-line/hdl/test_harness/sim/test_test_harness.sv

//Test top level test harness module
`include "../src/uart_msg_consts.h"
`timescale 1ps/1ps
module test_test_harness;

parameter integer DATA_WIDTH = 8;
parameter integer STOP_BITS = 1;
parameter integer BAUD = 9600;
parameter integer CLK_RATE = 54_000_000;

localparam integer CLKS_PER_BAUD = (CLK_RATE / BAUD);
localparam realtime CLK_PERIOD = (1.0s / CLK_RATE);
localparam realtime BAUD_PERIOD = (1.0s / BAUD);

localparam integer WORDS_PER_PACKET = `UART_MSG_WIDTH / DATA_WIDTH;

//Clock
logic clk = 0;
always #(CLK_PERIOD/2) clk = !clk;

//DUT
logic uart_tb_tx_fpga_rx, uart_tb_rx_fpga_tx, in =0, out;
test_harness_wrapper dut(.clk_in(clk), .uart_rx_pin(uart_tb_tx_fpga_rx), .in_sig(in), .uart_tx_pin(uart_tb_rx_fpga_tx), .out_sig(out), .output_clk(), .in_demod(), .sample(), .next_word(), .clk_out());
defparam dut.pllb0.uut.CLK_FREQ = CLK_RATE; //Normal
//defparam dut. \pll0.test_harness_wrapper_pll_inst .CLK_FREQ = CLK_RATE; //Post pnr
//defparam dut. pll0.test_harness_wrapper_pll_inst .CLK_FREQ = CLK_RATE; //Post synth

assign (highz1,weak0) out_sig = 1'b0; //Drive weak 0 due to tristate output (simulate pulldown)

//Emulate delay line
//Delay is number of numbers * bits per number * bit period
localparam integer no_nums = 16;
localparam realtime pulse_width = 49*CLK_PERIOD;
localparam realtime pulse_gap = 54*CLK_PERIOD;
always @(out)
begin
	automatic realtime delay = (no_nums * `UART_RECEIVED_WRONG_NUM_DATA_WIDTH *(pulse_width + pulse_gap));
	in <= #delay out;
end

//UART Receiver
reg [DATA_WIDTH-1:0] received_num;
reg receive_done = 0;
integer rec_iter;
always @(posedge clk) //Sample on clock edge
begin
	if(0 == uart_tb_rx_fpga_tx) //If we have a start bit
	begin
//		$display("Begin start at %t", $realtime);
		#(0.5*BAUD_PERIOD);//Half way through start bit
//		$display("Start sample");
		for(rec_iter=0; rec_iter < DATA_WIDTH; rec_iter++) //Get data bits
		begin
			#BAUD_PERIOD;
//			$display("Data sample at %t", $realtime);
			received_num[rec_iter] = uart_tb_rx_fpga_tx;
		end
	
		for(rec_iter=0; rec_iter < STOP_BITS; rec_iter++)
		begin
			#BAUD_PERIOD;
//			$display("Stop sample at %t", $realtime);
			assert(1 == uart_tb_rx_fpga_tx);
		end
		//We are now done, and are half way through the last stop bit
		receive_done = 1;
		#1
		receive_done = 0;
	end
end

integer message_count =0;
logic [63:0] total_msg;
always @(posedge receive_done)
begin
	message_count = message_count +1;
	total_msg[63:56] = received_num;
	if(message_count == 8)
	begin
		$display("Received %X at time %t", total_msg, $realtime);
		message_count = 0;
		total_msg = 0;
	end
	total_msg >>= 8;
end

//Uart transmit noise generator
logic uart_transmit_noise;
initial
begin
	uart_transmit_noise = 0;
	forever
	begin
		#(1ns * $urandom_range(500,1000));//Random delay
		uart_transmit_noise = 1;
		#(1ns * $urandom_range(1,2));//Random delay
		uart_transmit_noise = 0;

	end
end
	
logic uart_transmit_data;

always_comb
	uart_tb_tx_fpga_rx = uart_transmit_data^uart_transmit_noise;

task uart_transmit;
input reg[DATA_WIDTH-1:0] num;
integer i;
begin
	//Transmit
	//Start bit
	uart_transmit_data = 0;
	#BAUD_PERIOD;
	//Data bits
	for(i=0;i<DATA_WIDTH; i++)
	begin
		uart_transmit_data = num[i];
		#BAUD_PERIOD;
	end
	//Stop bits
	for(i=0; i<STOP_BITS; i++)
	begin
		uart_transmit_data = 1;
		#BAUD_PERIOD;
	end 
end
endtask


task uart_transmit_packet;
input logic `UART_HEADER_SIZE header;
input logic `UART_PAYLOAD_SIZE payload;
logic `UART_MSG_SIZE msg;
integer i;
begin
	msg `UART_HEADER_BITS = header;
	msg `UART_PAYLOAD_BITS = payload;
	$display("Sending %X at time %t", msg, $realtime);
	for(i=0; i < WORDS_PER_PACKET; i++)
	begin
		uart_transmit(msg[(DATA_WIDTH -1): 0]);
		msg = msg >> DATA_WIDTH;
	end
end
endtask

localparam realtime SPACE_DELAY = 1ms;
localparam realtime END_DELAY = 500ms;

//Stimulus
integer i;
logic `UART_PAYLOAD_SIZE payload;
initial
begin
	uart_transmit_data = 1;
	#SPACE_DELAY;

	uart_transmit_packet(`UART_HEADER_SYS_STATUS,0); //Stop
	#SPACE_DELAY;

	payload = 0;
	payload `UART_MEM_PARAMS_NO_NUMS_PAYLOAD_BITS = 16; //16 Numbers
	payload `UART_MEM_PARAMS_TEST_MODE_PAYLOAD_BITS = 0; //Test mode off
	payload `UART_MEM_PARAMS_PULSE_WIDTH_PAYLOAD_BITS = 49; // 0.9us
	payload `UART_MEM_PARAMS_PULSE_GAP_PAYLOAD_BITS = 54; // 1us
	uart_transmit_packet(`UART_HEADER_MEM_PARAMS,payload); //Setup memory manager
	#SPACE_DELAY;

	payload = 0;
	payload `UART_MOD_PARAMS_CYCLES_PER_HALF_PERIOD_PAYLOAD_BITS = 2;
	uart_transmit_packet(`UART_HEADER_MOD_PARAMS,payload); //Setup modulator
	#SPACE_DELAY;

	payload = 0;
	payload `UART_DEMOD_PARAMS_PULSE_WIDTH_PAYLOAD_BITS = 81; //1.5us
	uart_transmit_packet(`UART_HEADER_DEMOD_PARAMS,payload); //Setup demodulator
	#SPACE_DELAY;

	uart_transmit_packet(`UART_HEADER_SYS_STATUS,0); //Stop
	#SPACE_DELAY;

	uart_transmit_packet(`UART_HEADER_SYS_STATUS,1); //Run
	#SPACE_DELAY;

	payload = 0;
	payload `UART_REPLACE_NUM_ADDR_PAYLOAD_BITS = 1;
	payload `UART_REPLACE_NUM_DATA_PAYLOAD_BITS = 3;
	uart_transmit_packet(`UART_HEADER_REPLACE_NUM,payload); //Replace the number at address 1 with 3
	#SPACE_DELAY;

	payload = 0;
	payload `UART_REPLACE_NUM_ADDR_PAYLOAD_BITS = 1;
	payload `UART_REPLACE_NUM_DATA_PAYLOAD_BITS = 0;
	uart_transmit_packet(`UART_HEADER_REPLACE_NUM,payload); //Replace the number at address 1 with 0

	#END_DELAY;
	$finish;
end

endmodule
