joshtyler/delay-line/hdl/common/sim/clock.sv

//Clock module
//Creates a 50/50 duty cycle clock
`timescale 1ps/1ps

module clock #(parameter realtime PERIOD) (output logic clk);

initial
begin
	clk = 0;
	forever
		#(PERIOD/2) clk = !clk;
end

endmodule
