joshtyler/delay-line/hdl/test_harness/src/replace_num_mem.v

//Memory To store replacement number
//The n_reset is syncronous, and must be valid for long enough that the module can erase its memory
`include "uart_msg_consts.h"

module replace_num_mem(clk,
                       n_reset,
                       wr_packet,
                       rd_addr,
                       rd_en, wr_en,
                       data_out,
                       valid_out
                       );

//Clocking/reset inputs
input clk, n_reset;

//Data input
input `UART_REPLACE_NUM_TOTAL_PAYLOAD_SIZE wr_packet; //Address and data to write
input `UART_REPLACE_NUM_ADDR_SIZE rd_addr;
input rd_en, wr_en; //Read and write enables

output `UART_REPLACE_NUM_DATA_SIZE data_out;
output valid_out; //Valid if the replacement data is valid


//Decode wr_packet
wire `UART_REPLACE_NUM_ADDR_SIZE wr_addr;
assign wr_addr = wr_packet `UART_REPLACE_NUM_ADDR_PAYLOAD_BITS;

wire `UART_REPLACE_NUM_DATA_SIZE wr_data;
assign wr_data = wr_packet `UART_REPLACE_NUM_DATA_PAYLOAD_BITS;


//Data memory
//Wide enough for data field and valid flag
reg wr_en_mem;
reg `UART_REPLACE_NUM_ADDR_SIZE wr_addr_mem;
reg [`UART_REPLACE_NUM_DATA_WIDTH:0] wr_data_mem;
reg clear; //Request to clear location
reg `UART_REPLACE_NUM_ADDR_SIZE clear_addr;

//Signals for erasing the memory when stopped
reg `UART_REPLACE_NUM_ADDR_SIZE erase_ctr =0; //NOTE THAT WE INITIALISE TO ZERO HERE. This is allowed because Lattice guarantees registers will initialise to 0


//This block handles clearing of a write request after reading
//It asumes that there will be at least one clock cycle where we are not writing before the next read
//This is a reasonable assumption!
always @(posedge clk)
begin
	if(!n_reset)
	begin
		//Clear the memory
		wr_en_mem <= 1;
		wr_addr_mem <= erase_ctr;
		wr_data_mem <= 0;
		erase_ctr <= erase_ctr + 1'b1;
	end else begin
		erase_ctr <= 0;
		wr_en_mem <= wr_en; //Default to write enable signals
		wr_addr_mem <= wr_addr;
		wr_data_mem <= {1'b1, wr_data}; //The '1' is the write flag
	
		//If we are waiting to clear, and we are not writing this cycle
		if(clear && !wr_en) 
		begin
			clear <= 0;
			wr_en_mem <= 1;
			wr_addr_mem <= clear_addr;
			wr_data_mem <= {1'b0, data_out};
		end
	
		//Check if we have a new location to clear
		//If so, store for later
		if(rd_en)
		begin
			clear <= 1;
			clear_addr <= rd_addr;
		end
	end
end

wire [`UART_REPLACE_NUM_DATA_WIDTH:0] rd_data_mem;
assign valid_out = rd_data_mem[`UART_REPLACE_NUM_DATA_WIDTH];
assign data_out = rd_data_mem[`UART_REPLACE_NUM_DATA_WIDTH-1:0];

dual_port_ram #(
		.WIDTH(`UART_REPLACE_NUM_DATA_WIDTH +1),
		.DEPTH(2**`UART_REPLACE_NUM_ADDR_WIDTH)
	) ram0 (
		.clk(clk),
		.wr_addr(wr_addr_mem),
		.wr_en(wr_en_mem),
		.wr_data(wr_data_mem),
		.rd_addr(rd_addr),
		.rd_en(rd_en),
		.rd_data(rd_data_mem)
	);



endmodule
