joshtyler/delay-line/hdl/test_harness/src/test_harness_consts.h

//Test harness consts

`ifndef TEST_HARNESS_CONSTS_H
`define TEST_HARNESS_CONSTS_H

`include "../src/uart_msg_consts.h"

`define DEFAULT_DEMOD_PARAMS 0 //Fill in with something useful!
`define DEFAULT_MOD_PARAMS 0 //Fill in with something useful!
`define DEFAULT_MEM_PARAMS 0 //Fill in with something useful!

`endif
