joshtyler/delay-line/(commit log)

2017-06-13 Post synth sim not working - Lattice models don't workgit status
    [delay_line.v, pll.v]
2017-06-14 UART Simulation working
2017-06-14 UART loopback not working
    [icestick.pcf, test_harness.v, test_test_harness.sv, uart_rx.v]
2017-06-14 TX only UART test working
2017-06-14 UART loopback working
2017-06-19 Memory manager working correctly in tb
    [mem_manager.v, replace_num_mem.v, shift_register.v, test_mem_manager.sv]
2017-06-19 Delay line de-inital valued and working in sim
2017-06-19 Added and tested message assembler and disassembler
2017-06-21 Basic FTDI driver working
2017-06-26 Single button GUI working
2017-07-03 Combined model works correctly. Pre-move to pure verilog
    [controller.v, delay_line.v, delay_line_wrapper.v, demodulator.v, icestick.pcf, mem_manager.v, modulator.v, pll.v]
2017-07-25 pre modify transformer schematic
2017-07-29 Main circuit working well
2017-08-04 At stage of ordering parts.
    [Farnell order 20170804.ods]
2017-08-09 Written more of the report
    [Farnell order 20170804.ods]
2017-08-28 Working in the tube!
2017-08-30 Minor fix to mem_gui, and demo slides are done
    [modulator_options.cpp]
2017-09-07 All diagrams now OK
    [delay_line.kicad_pcb, delay_line.sch, test_harness.kicad_pcb, test_harness.sch]
2017-09-07 Printing draft
2018-01-27 Ordered output PCB - v1.0
    [Farnell order 20170804.ods, fpga.sch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]
2018-05-28 SPI Prog now working with single bit write
    [Farnell order 20180206.ods, fpga.sch, input_pcb.kicad_pcb, input_pcb.sch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]
2018-08-28 Working spi programmer
2018-09-10 Add output pcb bringup
2020-02-09 First steps towards adding support for SPI programming over wishbone FPGA component
2020-02-09 Plumbed in framework for choosing target
